raulvel/licenta/Velcherean_Raul_presentation.odp

## Indoor positioning system

Author: Velcherean Raul

Supervisor: asis.eng. Harja Gabriel

## What is a positioning system?

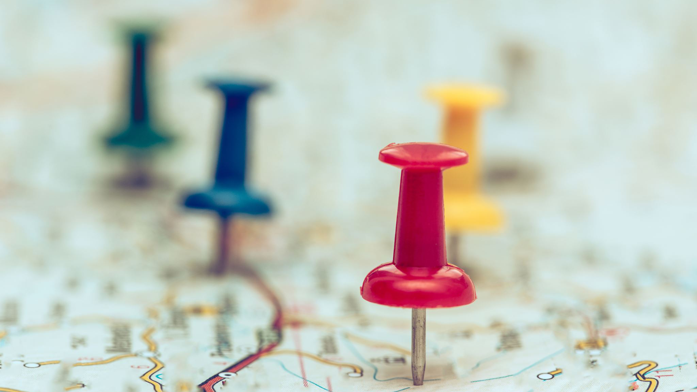
[picture p1: figure]

## Global Positioning System

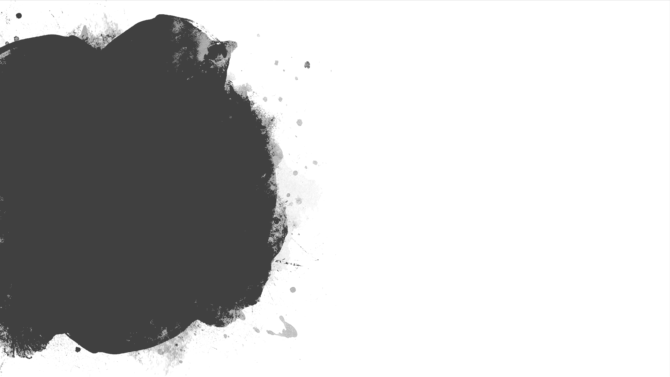
[picture p2: figure]
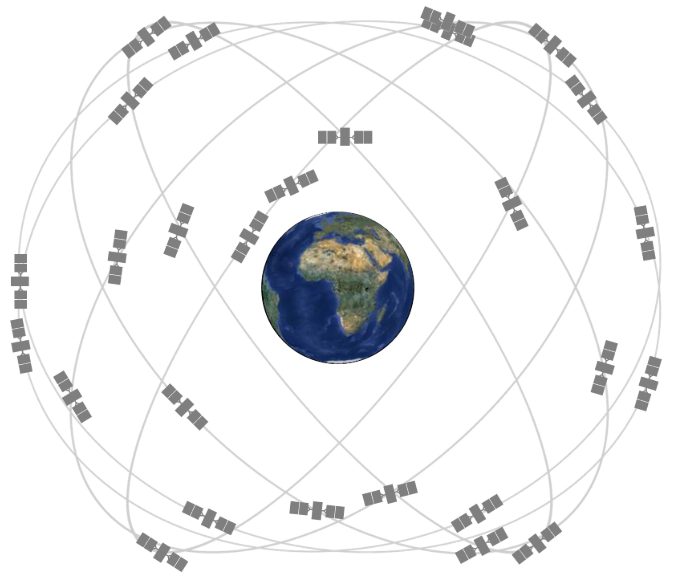
[picture p3: figure]

## Slide 4

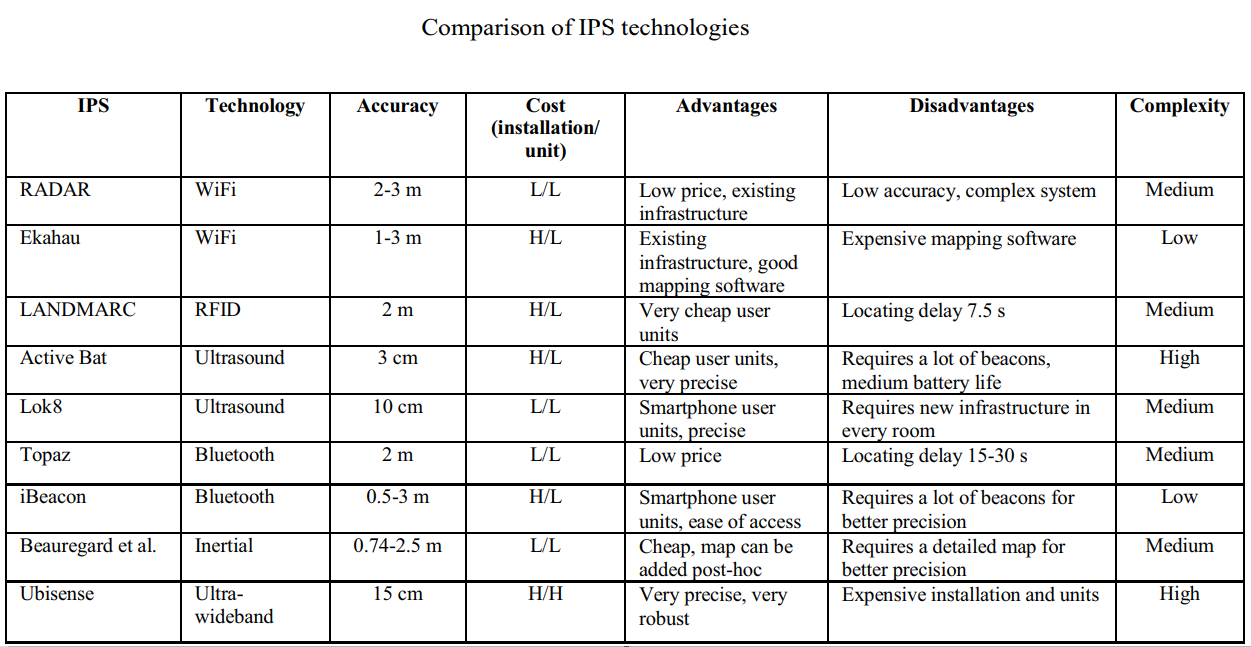
[picture p4: figure]

## UWB – Ultra Wide Band

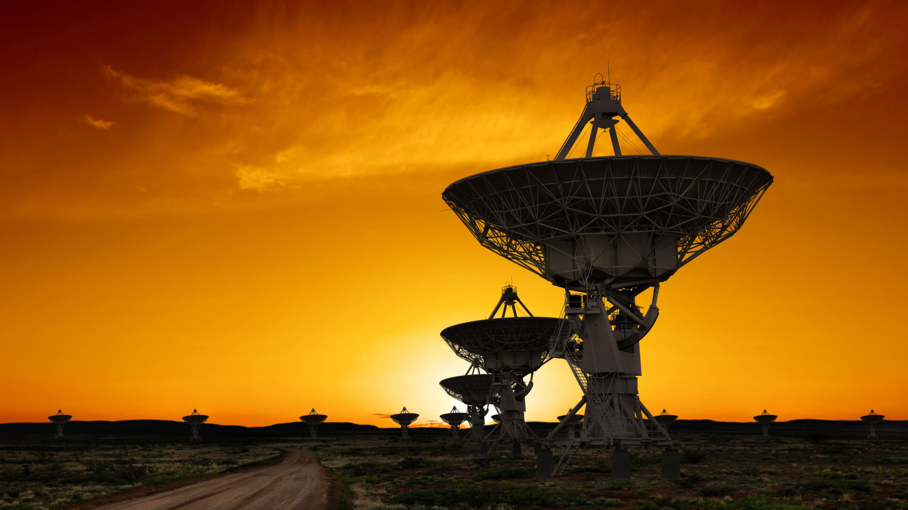
[picture p5: figure]

## DWM1000

- Transceiver IC with antenna, all RF circuitry, power management and clock circuitry all in one
- 4 RF bands (3.5GHz to 6.5 GHz)
- Low power consumption
- Data rates: 110 kbps, 850 kbps, 6.8 Mbps
- 63.8976 GHz sampling clock used for ranging (15.65 ps period)
- 23 mm x 13 mm x 2.9 mm

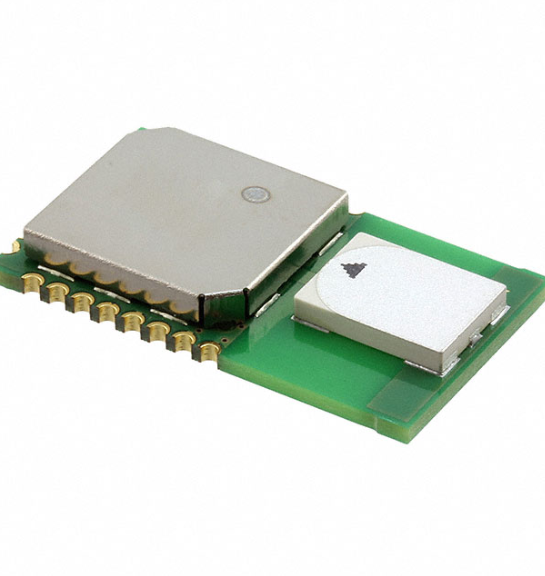
[picture p6: figure]

## Microcontroller – DWM1000 connection

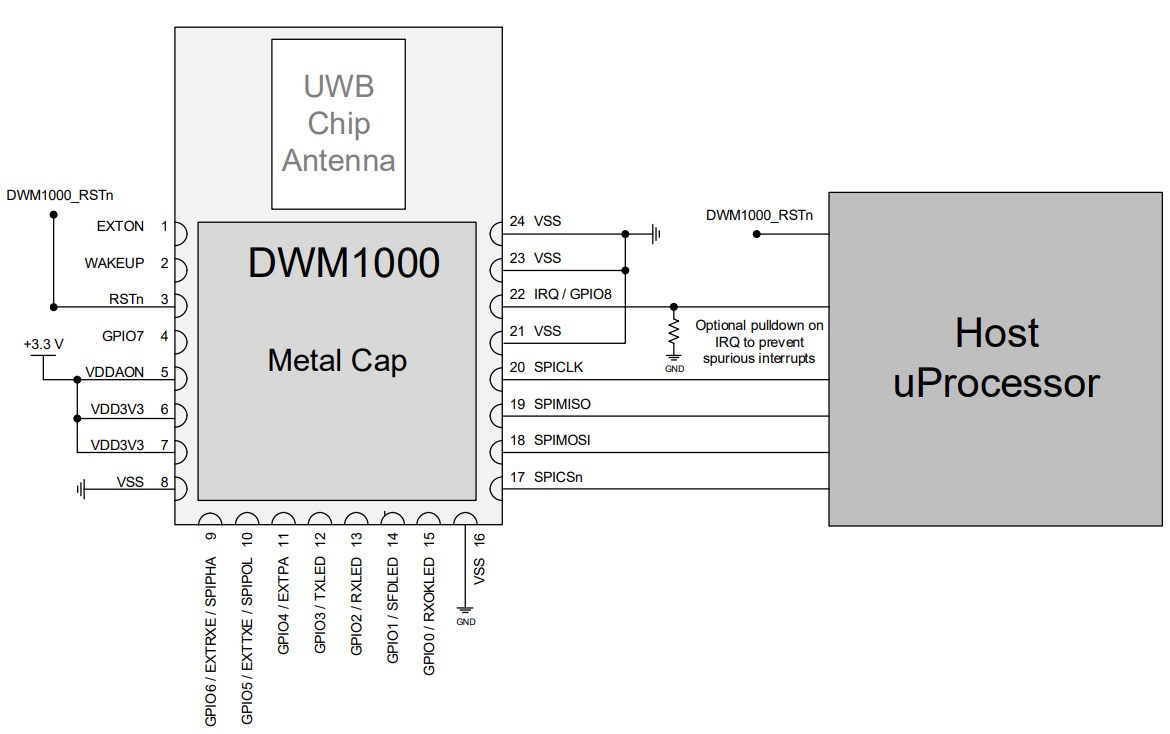
[picture p7: figure]

## Design of the PCB

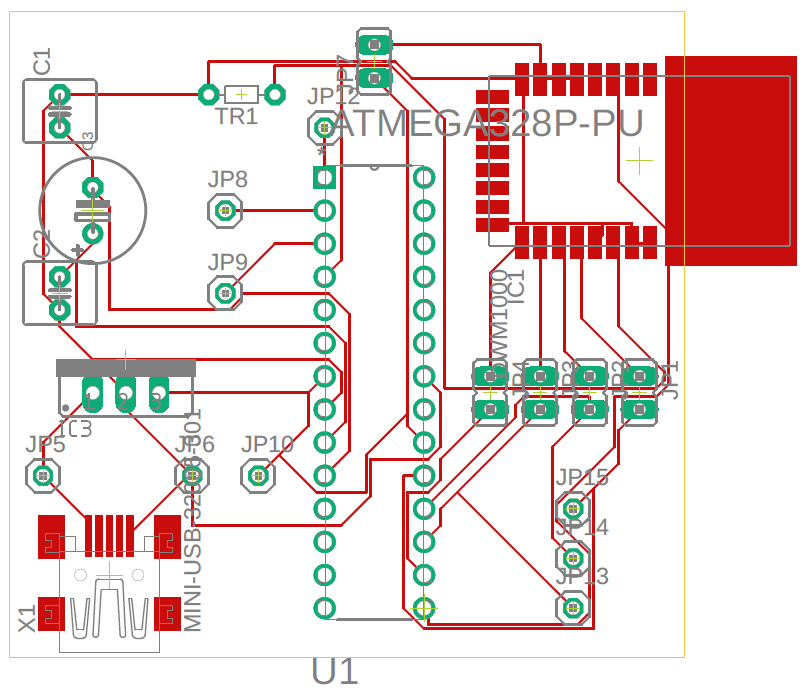
[picture p8: figure]

- DWM1000
- ATmega328P
- 3.3V voltage regulator
- Mother mini-USB connector
- Capacitors, Oscillator, Pins

## Final form

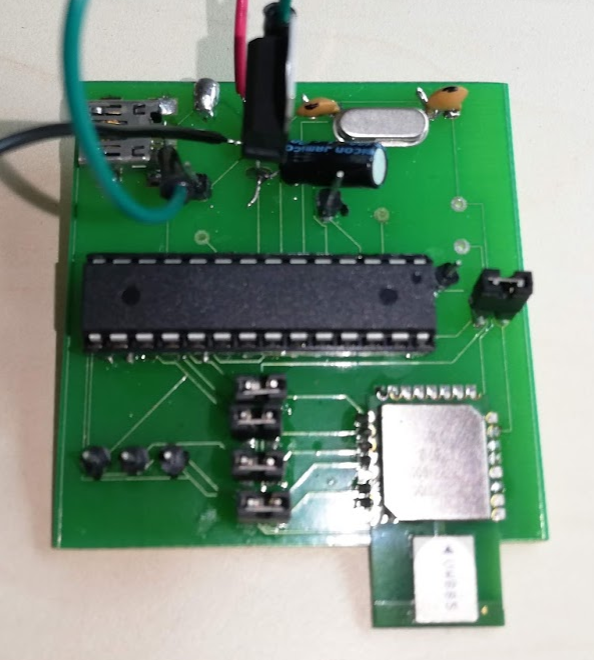
[picture p9: figure]

1. TAG –POLL→ ANCHOR
2. ANCHOR –POLL_ACK→ TAG
3. TAG –RANGE→ ANCHOR
4. ANCHOR–RANGE_RESPONSE→TAG

## Trilateration

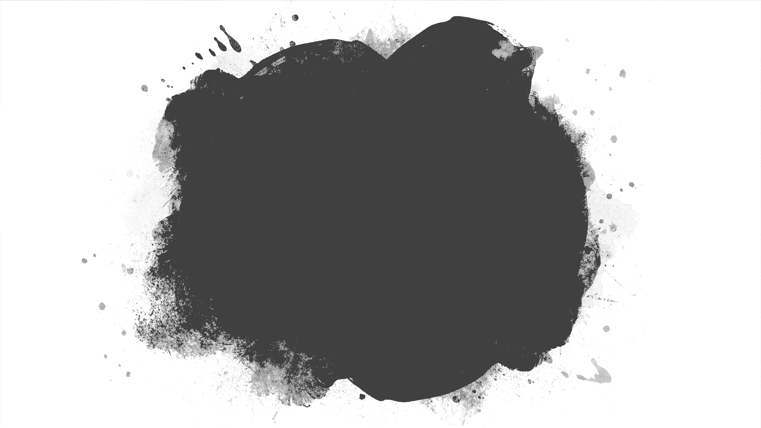
[picture p10: figure]

## Slide 11

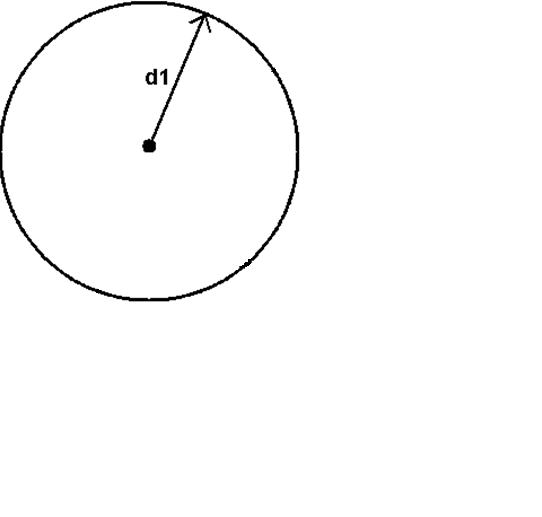
[picture p11: figure]

## Slide 12

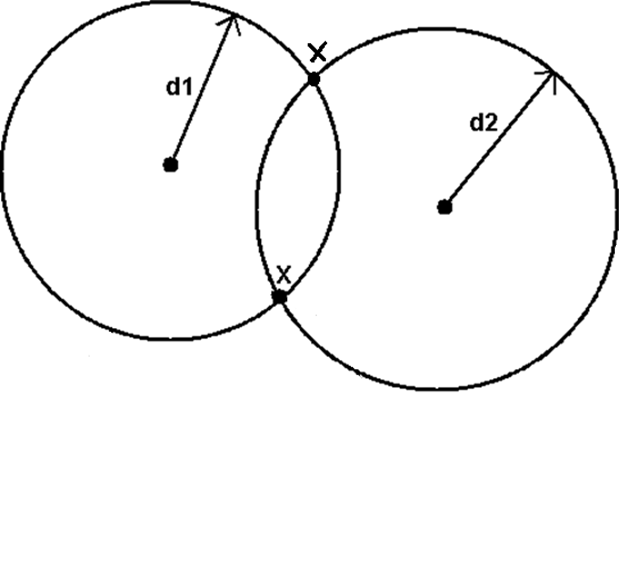
[picture p12: figure]

## Slide 13

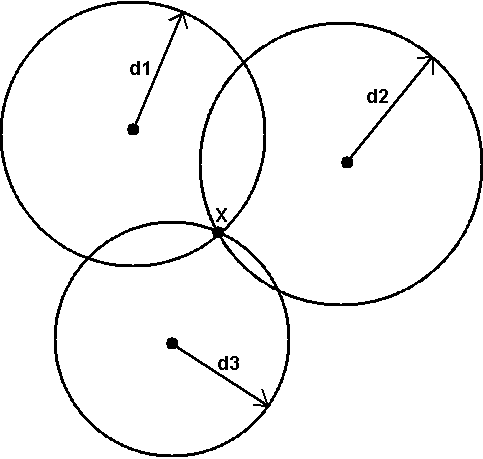
[picture p13: figure]

## Single-sided two-way ranging

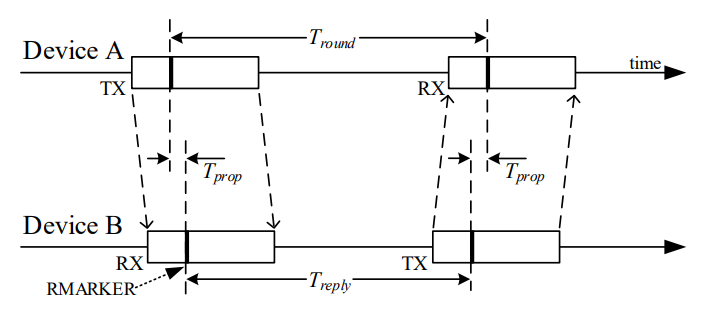
[picture p14: figure]

## Single-sided two-way ranging

## Slide 16

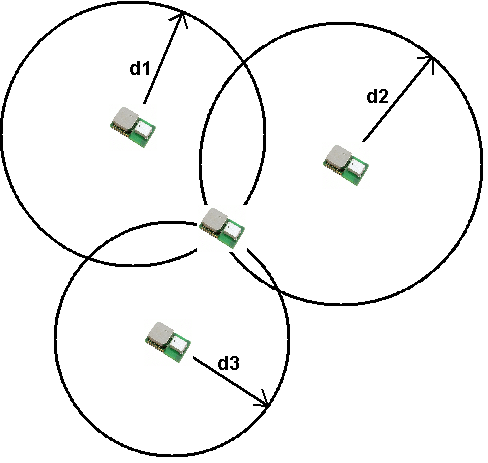
[picture p15: figure]

## Slide 17

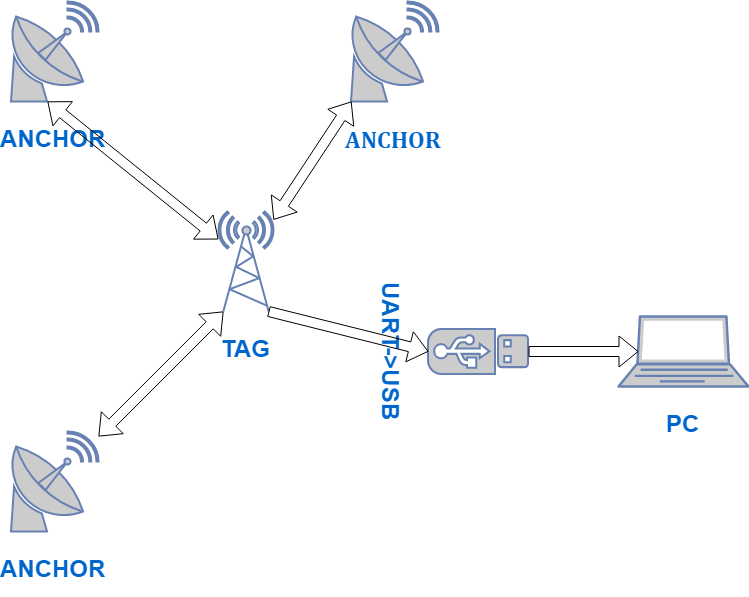
[picture p16: figure]

## Modified trilateration

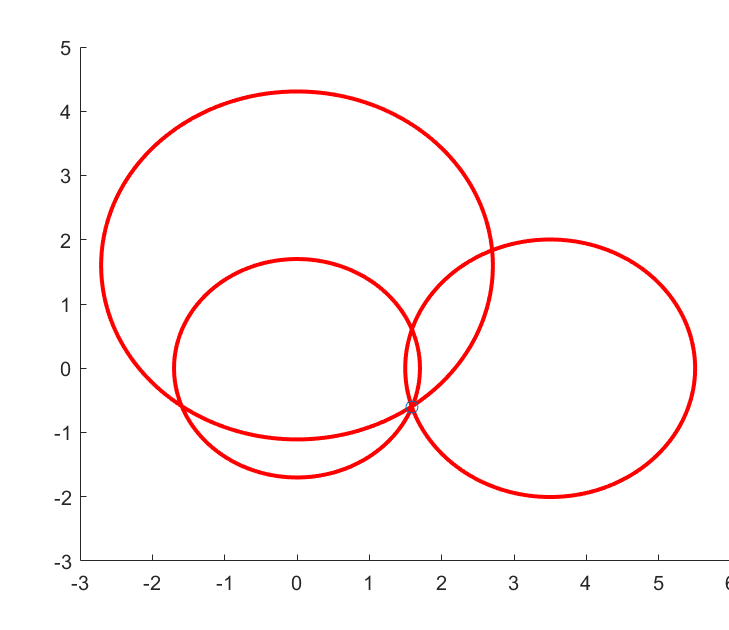
[picture p17: figure]

- Calculate the intersection of 2 circles
- Calculate which point from the previous step is close to the third circle

## Intersection of 2 circles

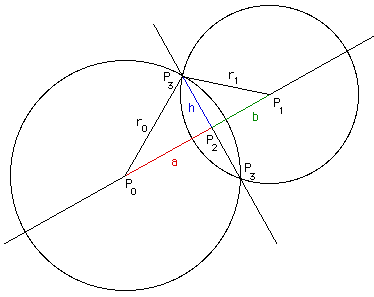
[picture p18: figure]

## Shortest distance from point to circle

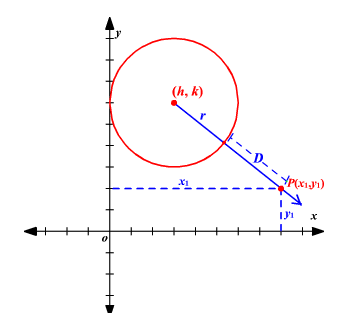
[picture p19: figure]

## Slide 21

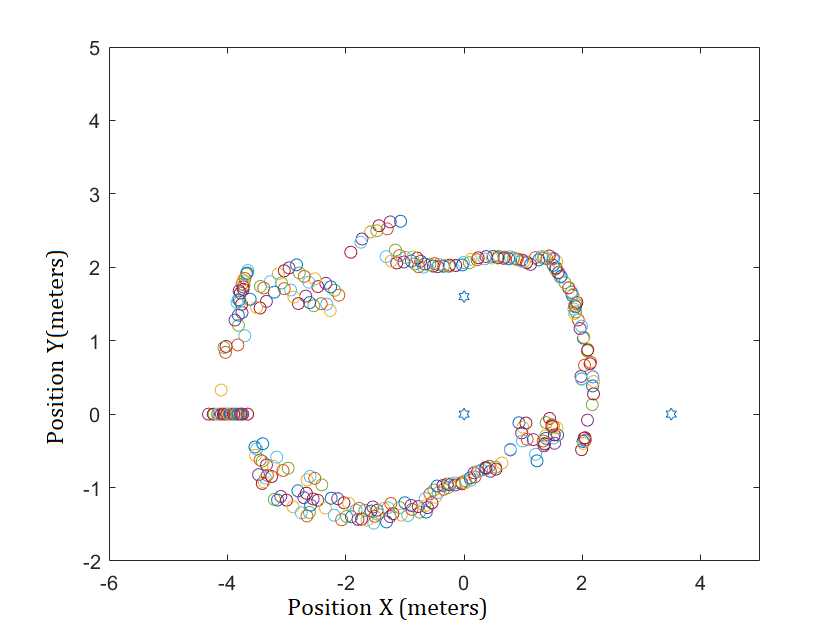
[picture p20: figure]

## Thank you for your attention

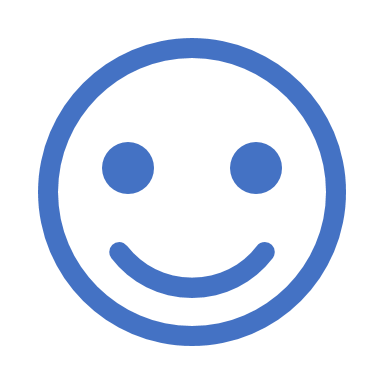
[picture p21: figure]
