raulvel/licenta/Velcherean_Raul_presentation.pptx

## Indoor positioning system

Author: Velcherean Raul
Supervisor: asis.eng. Harja Gabriel

## What is a positioning system?


## Global Positioning System


## Slide 4


## UWB – Ultra Wide Band


## DWM1000

- Transceiver IC with antenna, all RF circuitry, power management and clock circuitry all in one
- 4 RF bands (3.5GHz to 6.5 GHz)
- Low power consumption
- Data rates: 110 kbps, 850 kbps, 6.8 Mbps
- 63.8976 GHz sampling clock used for ranging (15.65 ps period)
- 23 mm x 13 mm x 2.9 mm

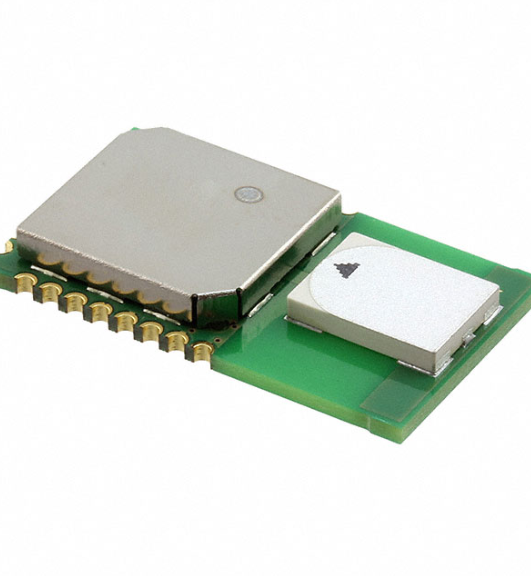
[picture p22: figure]

## Microcontroller – DWM1000 connection


## Design of the PCB

- DWM1000
- ATmega328P
- 3.3V voltage regulator
- Mother mini-USB connector
- Capacitors, Oscillator, Pins

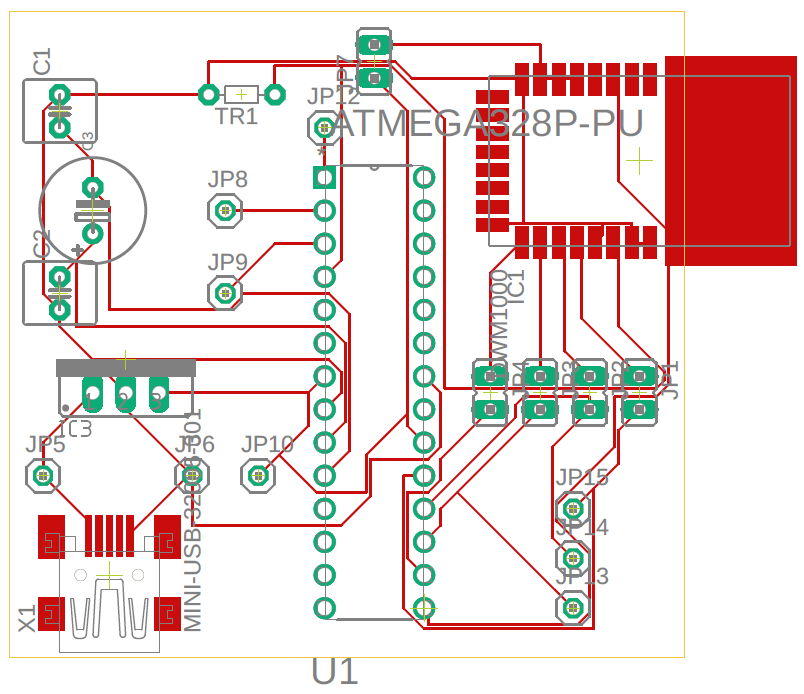
[picture p23: figure]

## Final form

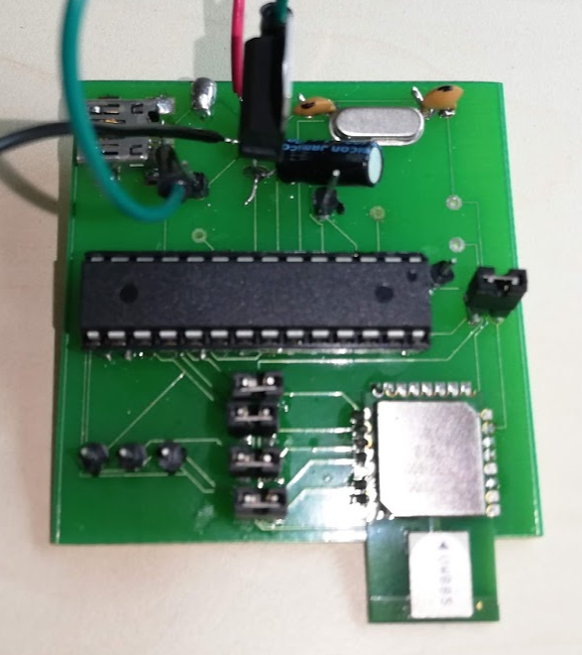
[picture p24: figure]

## Trilateration


## Slide 11


## Slide 12


## Slide 13


## Single-sided two-way ranging


## Single-sided two-way ranging

## Slide 16


## Slide 17


## Modified trilateration

- Calculate the intersection of 2 circles
- Calculate which point from the previous step is close to the third circle


## Intersection of 2 circles

- x_3 =x_2 ±(h(y_1 −y_0 ))/d
- y_3 =y_2 ∓(h(x_1 −x_0 ))/d
- d=||P_1 −P_0 ||
- a=(r_0^2 −r_1^2 +d^2)/(2d)
- h=√(r_0^2 −a^2)
- P_2 =P_0 +(a(P_1 −P_0 ))/d

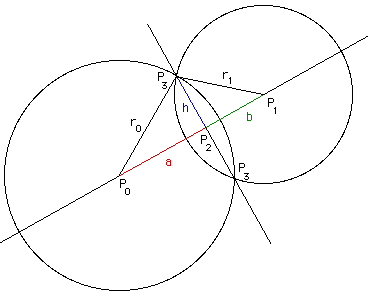
[picture p25: figure]

## Shortest distance from point to circle

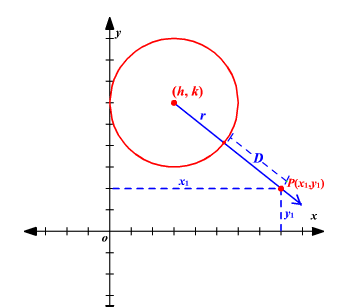
[picture p26: figure]

- d=|√((x_1 −h)^2 +(y_1 −k)^2)−r|

## Slide 21


## Thank you for your attention
