raulvel/licenta/07_16_Velcherean_Raul.pptx

## Indoor monitoring system

Velcherean Raul

## Global Positioning System


## Trilateration


## DWM1000

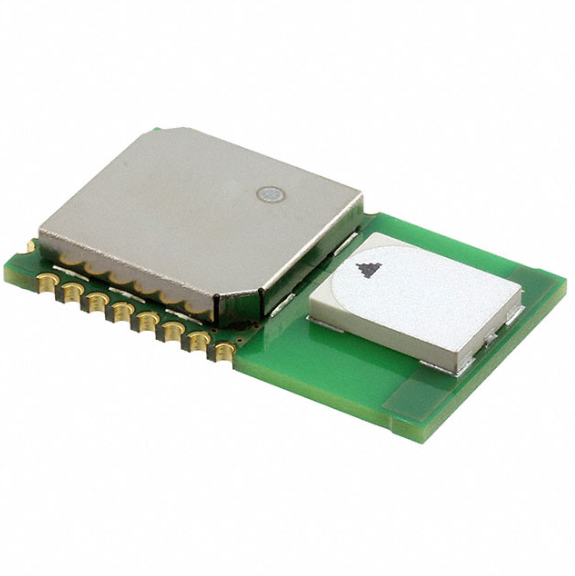
[picture p61: figure]

## Slide 5


## Thank you for your attention
