raulvel/licenta/resources/arduino-dw1000-master/adapterBoard/AdapterBoardTestBed.png

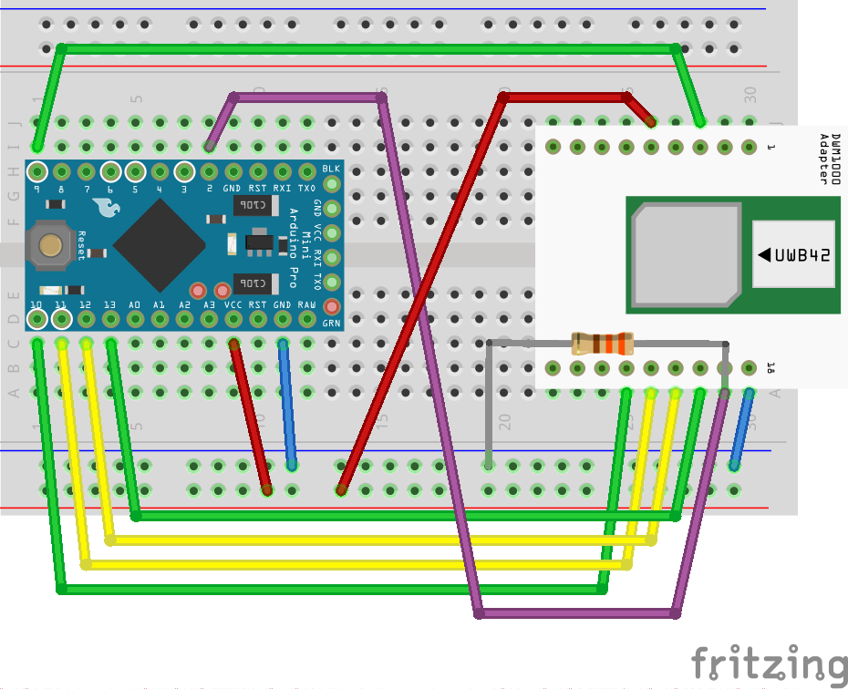
resources/arduino-dw1000-master/adapterBoard/AdapterBoardTestBed.png
