raulvel/licenta/resources/arduino-dw1000-master/examples/BasicConnectivityTest/ss.png

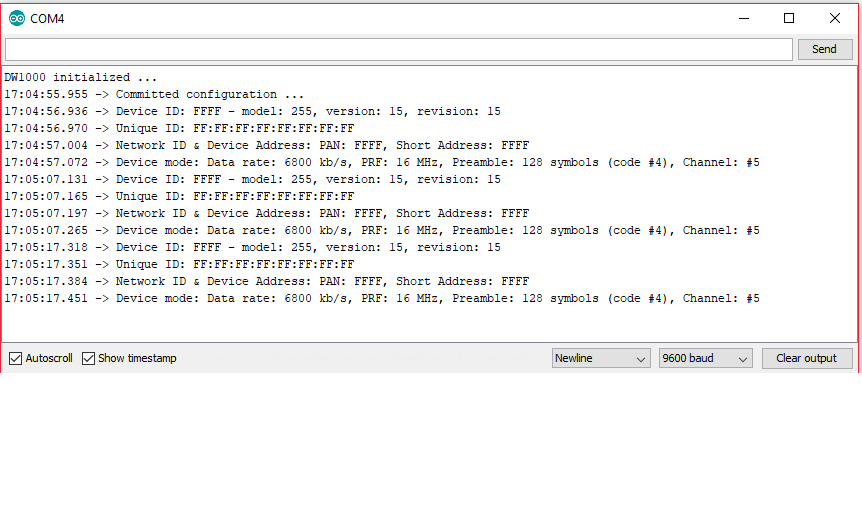
resources/arduino-dw1000-master/examples/BasicConnectivityTest/ss.png
