raulvel/licenta/deca_pcb/deca_pcb1-1.pdf

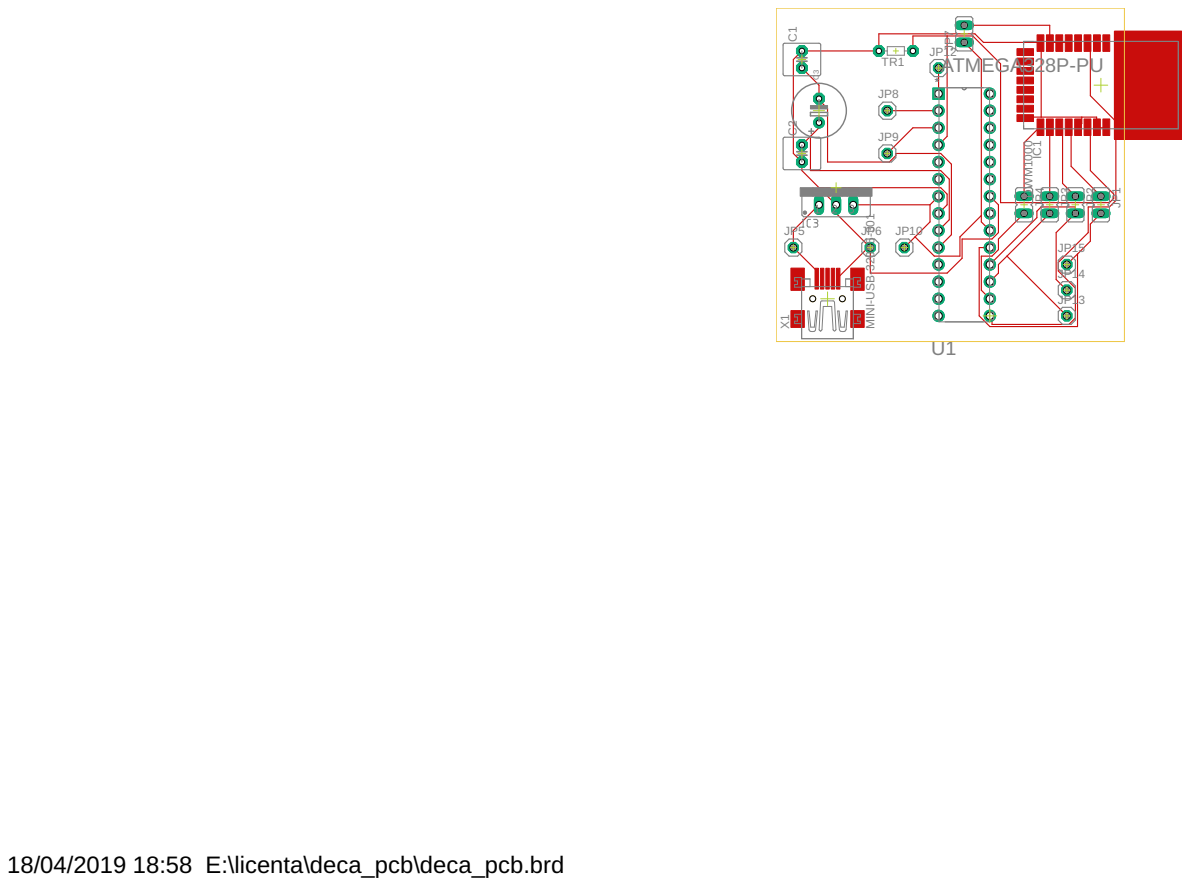
[picture p64: page 1]
