raulvel/licenta/deca_pcb/deca_pcb.pdf

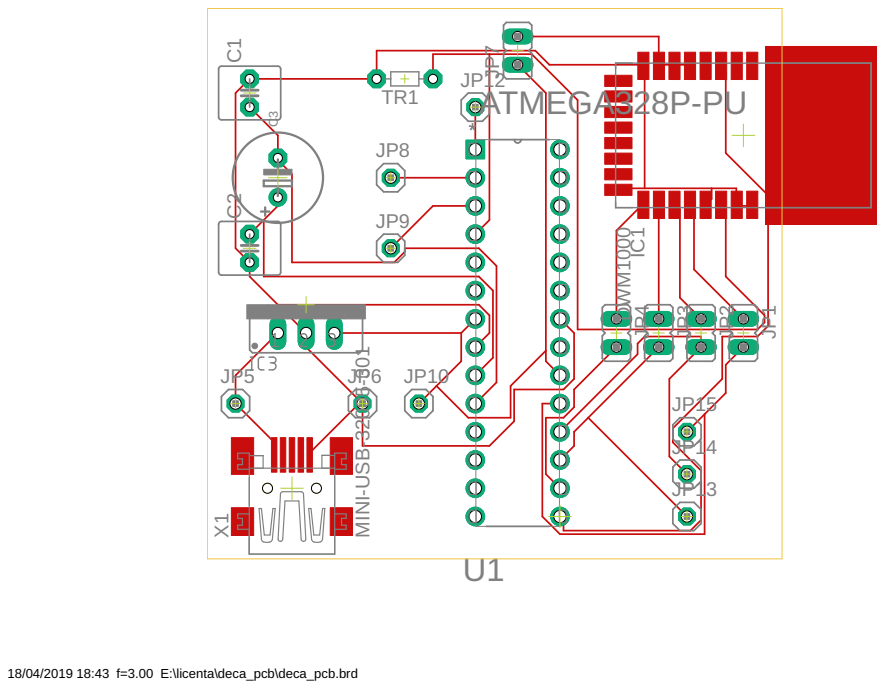
[picture p65: page 1]
