raulvel/licenta/(list of files, drawings)

Other design files:
resources/arduino-dw1000-master/adapterBoard/adapterBoard pdf/adapterBoard.fzz
resources/arduino-dw1000-master/adapterBoard/adapterBoard pdf/AdapterBoardTestBed.fzz
