raulvel/licenta/deca_pcb/deca_pcb.brd

## EAGLE design deca_pcb/deca_pcb.brd (2019-06-04)

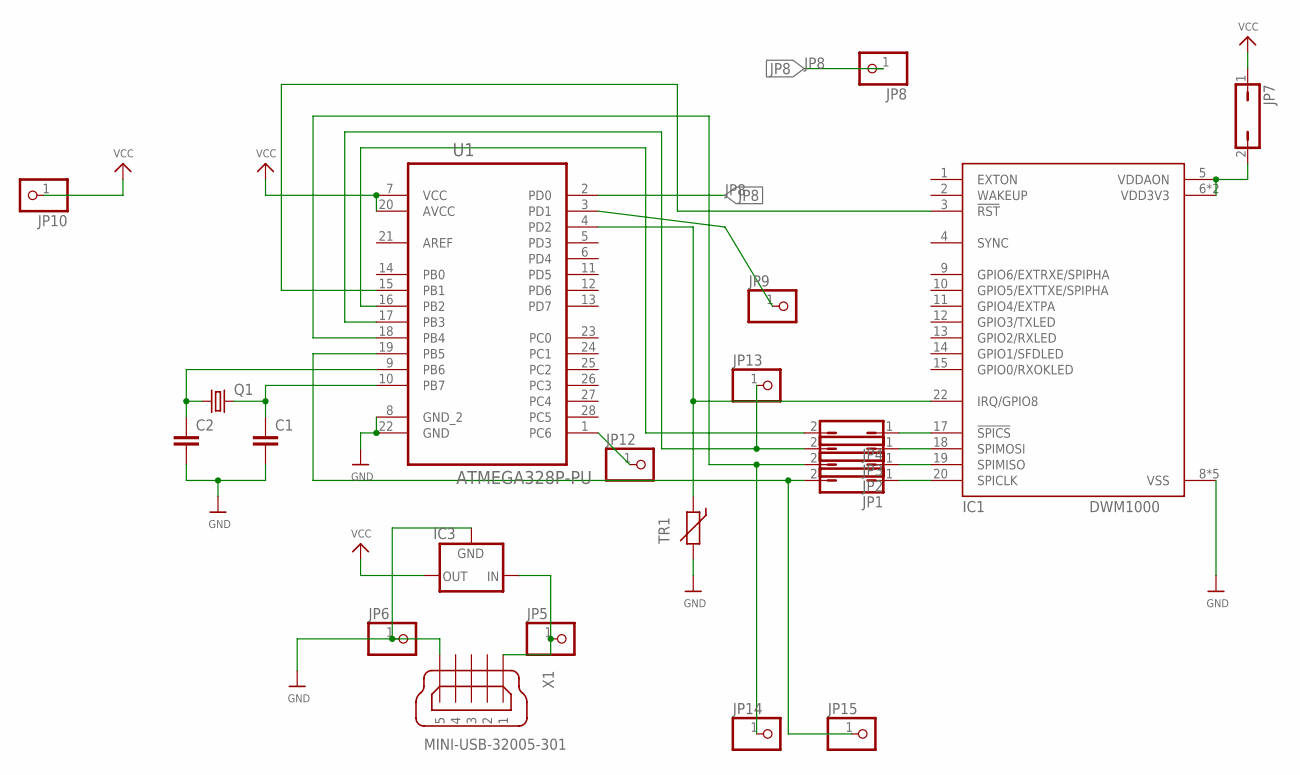
[picture p66: schematic deca_pcb.sch]

Parts:
C1, C2: C2.5/6; C2.5-6
IC1: DWM1000
IC3: LFXXCVS; TO220S
JP1, JP2, JP3, JP4, JP7: JP1Q; JP1
JP5, JP6, JP8, JP9, JP10, JP12, JP13, JP14, JP15: PINHD-1X1_2.54; 1X01
Q1: CRYSTALHC49S; HC49/S
TR1: THERMISTOR_R-5; R-5
U1: ATMEGA328P-PU; DIP254P762X457-28
X1: MINI-USB-32005-301; 32005-301

Connections:
GND: C1.2, C2.2, IC1.8 (VSS), IC1.16 (VSS), IC1.21 (VSS), IC1.23 (VSS), IC1.24 (VSS), IC3.2 (GND), JP6.1, TR1.2, U1.8 (GND_2), U1.22 (GND), X1.5
JP8: JP8.1, U1.2 (PD0)
unnamed: JP1.2, JP15.1, U1.19 (PB5)
unnamed: JP2.2, JP14.1, U1.18 (PB4)
unnamed: JP3.2, JP13.1, U1.17 (PB3)
unnamed: JP4.2, U1.16 (PB2)
unnamed: IC1.22 (IRQ/GPIO8), TR1.1, U1.4 (PD2)
unnamed: IC1.3 (!RST), U1.15 (PB1)
unnamed: C2.1, Q1.1, U1.9 (PB6)
unnamed: C1.1, Q1.2, U1.10 (PB7)
unnamed: IC1.5 (VDDAON), IC1.6 (VDD3V3), IC1.7 (VDD3V3), JP7.2
unnamed: IC3.1 (IN), JP5.1, X1.1
unnamed: IC1.20 (SPICLK), JP1.1
unnamed: IC1.19 (SPIMISO), JP2.1
unnamed: IC1.18 (SPIMOSI), JP3.1
unnamed: IC1.17 (!SPICS), JP4.1
unnamed: JP9.1, U1.3 (PD1)
unnamed: JP12.1, U1.1 (PC6)
VCC: IC3.3 (OUT), JP7.1, JP10.1, U1.7 (VCC), U1.20 (AVCC)

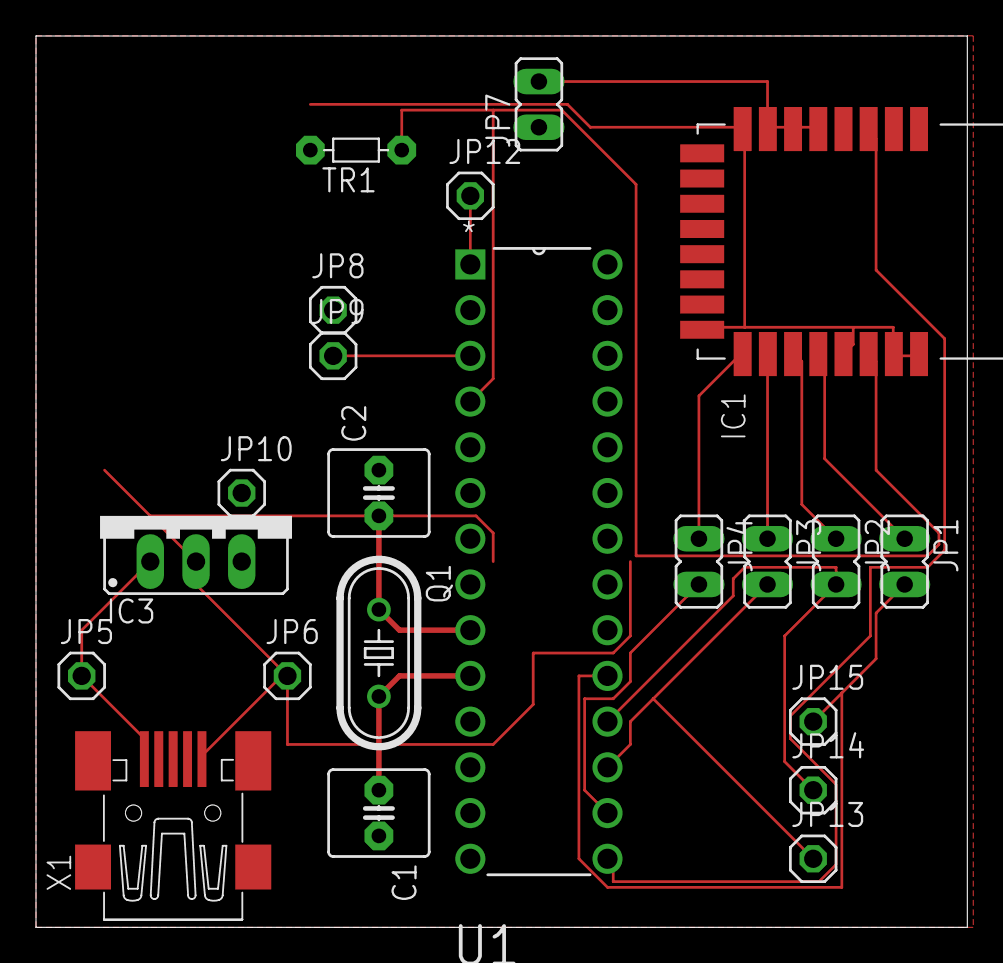
[picture p67: board deca_pcb.brd from above]

Board: 2 copper layers, 51.7 x 49.5 mm, 22 parts (0 on the bottom side), 19 nets.
