raulvel/licenta/resources/arduino-dw1000-master/adapterBoard/dwm1000 arduino standalone/one_sided_standalone_DWM1000.brd

## EAGLE design resources/arduino-dw1000-master/adapterBoard/dwm1000 arduino standalone/one_sided_standalone_DWM1000.brd (2019-04-12)

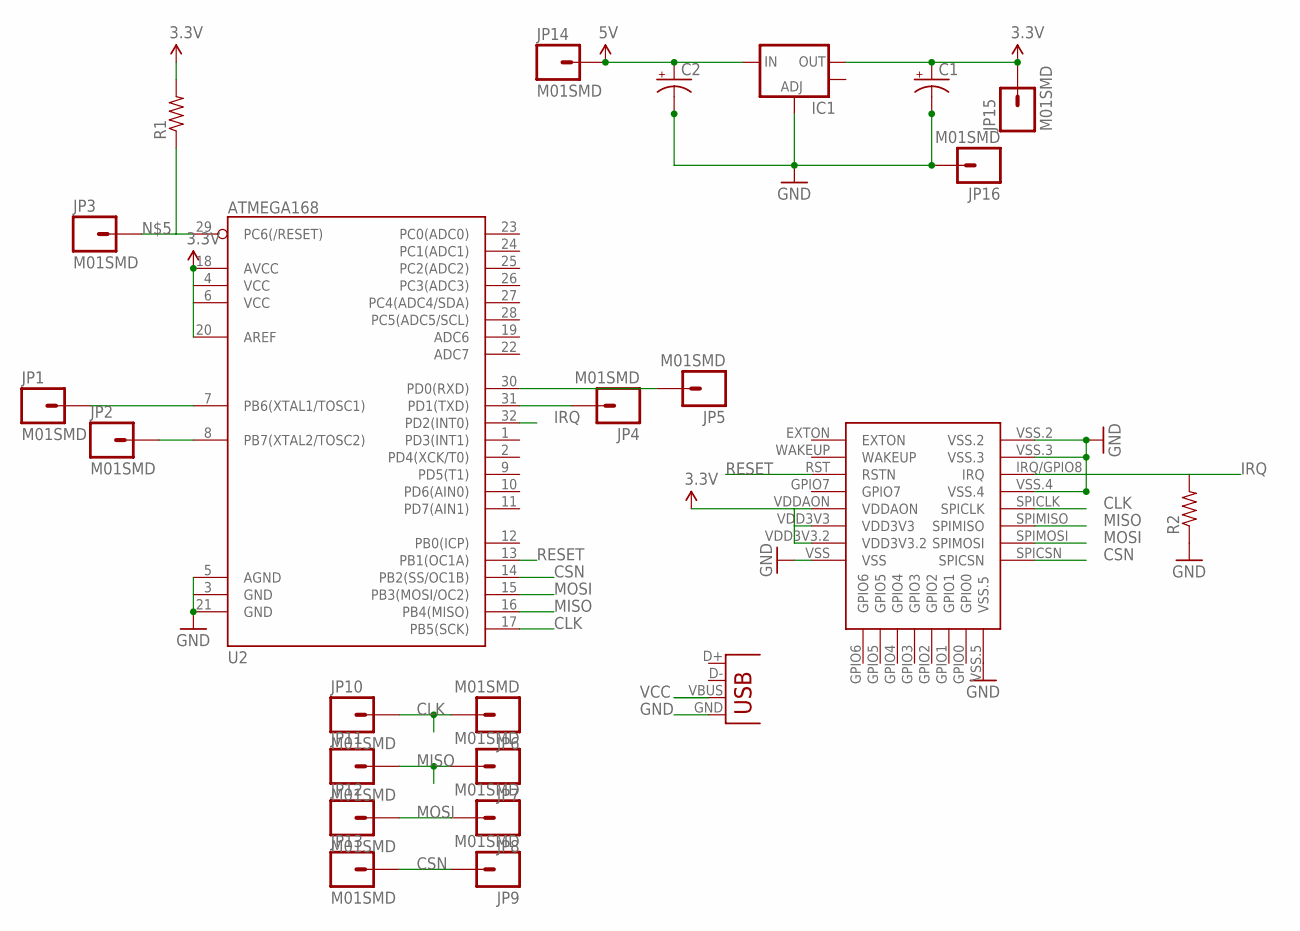
[picture p68: schematic one_sided_standalone_DWM1000.sch]

Parts:
C1, C2: CAP_POL3528-KIT; EIA3528-KIT
IC1: V_REG_LM1117SOT223; SOT223
JP1, JP2, JP3, JP4, JP5, JP6, JP7, JP8, JP9, JP10, JP11, JP12, JP13, JP14, JP15, JP16: M01SMD; LUXEON-PAD
R1, R2: RESISTOR0805-RES; 0805
U2: ATMEGA168; TQFP32-08
U$1: DWM1000
X1: USB-MICROB

Connections:
CLK: JP6.P$1, JP10.P$1, U2.17 (PB5(SCK)), U$1.SPICLK
CSN: JP9.P$1, JP13.P$1, U2.14 (PB2(SS/OC1B)), U$1.SPICSN
GND: C1.C (-), C2.C (-), IC1.1 (ADJ), JP16.P$1, R2.1, U2.3 (GND), U2.5 (AGND), U2.21 (GND), U$1.VSS, U$1.VSS.2, U$1.VSS.3, U$1.VSS.4, U$1.VSS.5, X1.GND
IRQ: R2.2, U2.32 (PD2(INT0)), U$1.IRQ/GPIO8 (IRQ)
MISO: JP7.P$1, JP11.P$1, U2.16 (PB4(MISO)), U$1.SPIMISO
MOSI: JP8.P$1, JP12.P$1, U2.15 (PB3(MOSI/OC2)), U$1.SPIMOSI
unnamed: JP1.P$1, U2.7 (PB6(XTAL1/TOSC1))
unnamed: JP2.P$1, U2.8 (PB7(XTAL2/TOSC2))
unnamed: JP3.P$1, R1.1, U2.29 (PC6(/RESET))
unnamed: JP4.P$1, U2.31 (PD1(TXD))
unnamed: JP5.P$1, U2.30 (PD0(RXD))
RESET: U2.13 (PB1(OC1A)), U$1.RST (RSTN)
VCC: C2.A (+), IC1.3 (IN), JP14.P$1, X1.VBUS
VCC3.3: C1.A (+), IC1.2 (OUT), JP15.P$1, R1.2, U2.6 (VCC), U2.18 (AVCC), U2.20 (AREF), U$1.VDD3V3, U$1.VDD3V3.2, U$1.VDDAON

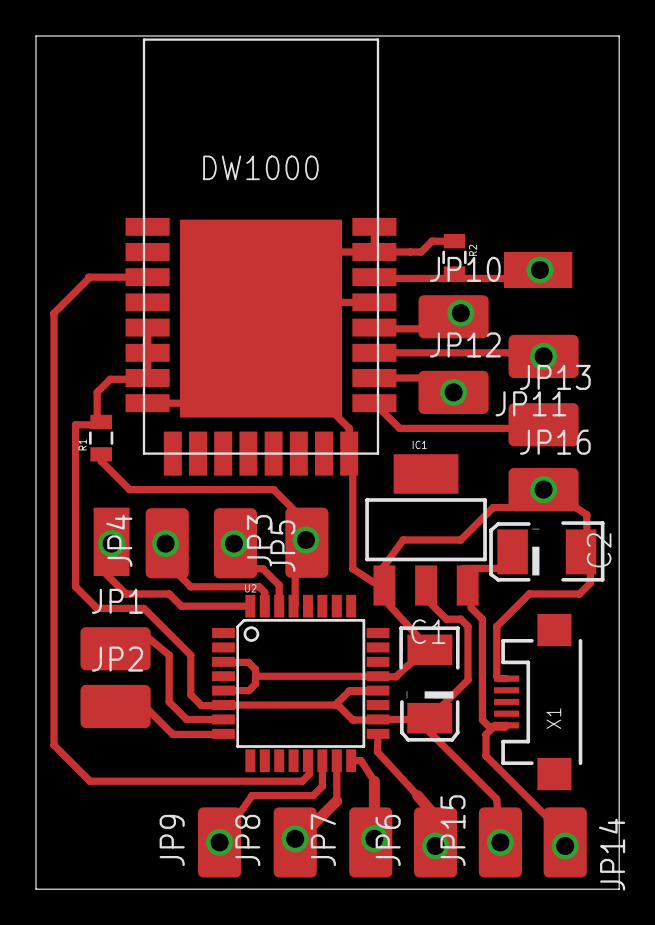
[picture p69: board one_sided_standalone_DWM1000.brd from above]

Board: 2 copper layers, 32.4 x 47.4 mm, 24 parts (0 on the bottom side), 14 nets.
