raulvel/licenta/(commit log)

2019-04-12 initial deca pcb
    [deca_pcb.sch]
2019-04-12 added connections from uC to DWM1000
    [deca_pcb.brd]
2019-04-15 added components
    [deca_pcb.brd, deca_pcb.sch]
2019-04-18 board pcb done
    [deca_pcb.brd, deca_pcb.sch]
