raulvel/licenta/(notices)

Notices in the files:
resources/arduino-dw1000-master/README.md:
License: Apache 2
parts and their libraries:
SparkFun: Licensing: CC v3.0 Share-Alike You are welcome to use this library for commercial purposes.
microbuilder: This work is placed in the public domain, and may be freely used for commercial and non-commercial work with the following conditions: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
